ammar0xff/capstone-pdm/book_assets/audio_spec.png

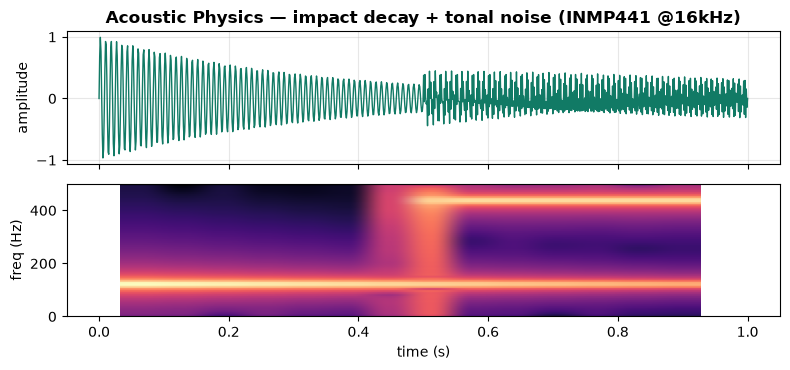
book_assets/audio_spec.png
