ammar0xff/capstone-pdm/book_assets/breadboard.png

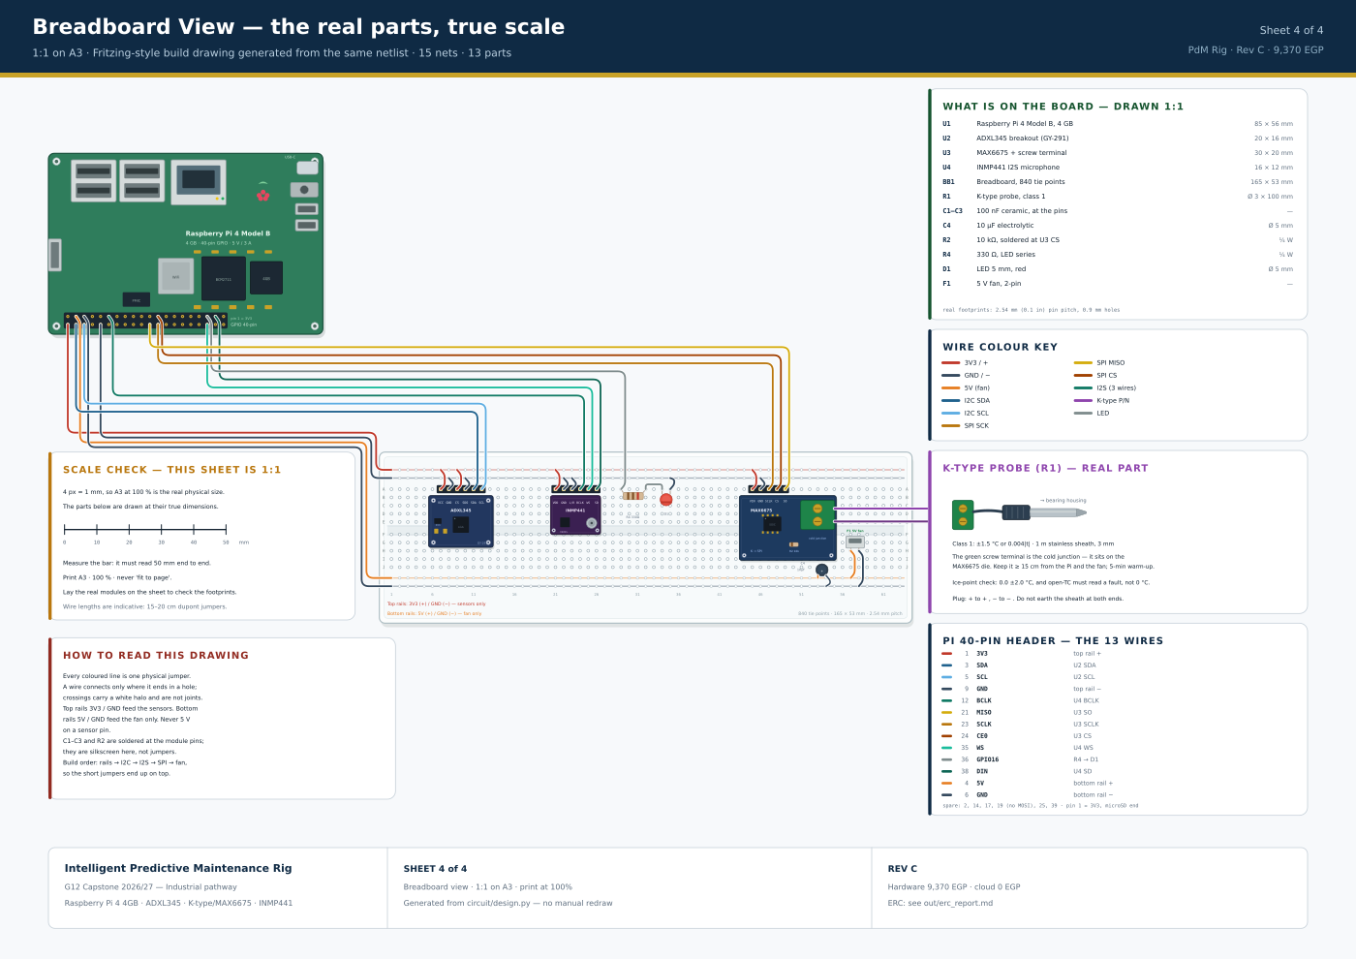
book_assets/breadboard.png
