ammar0xff/capstone-pdm/book_assets/budget.png

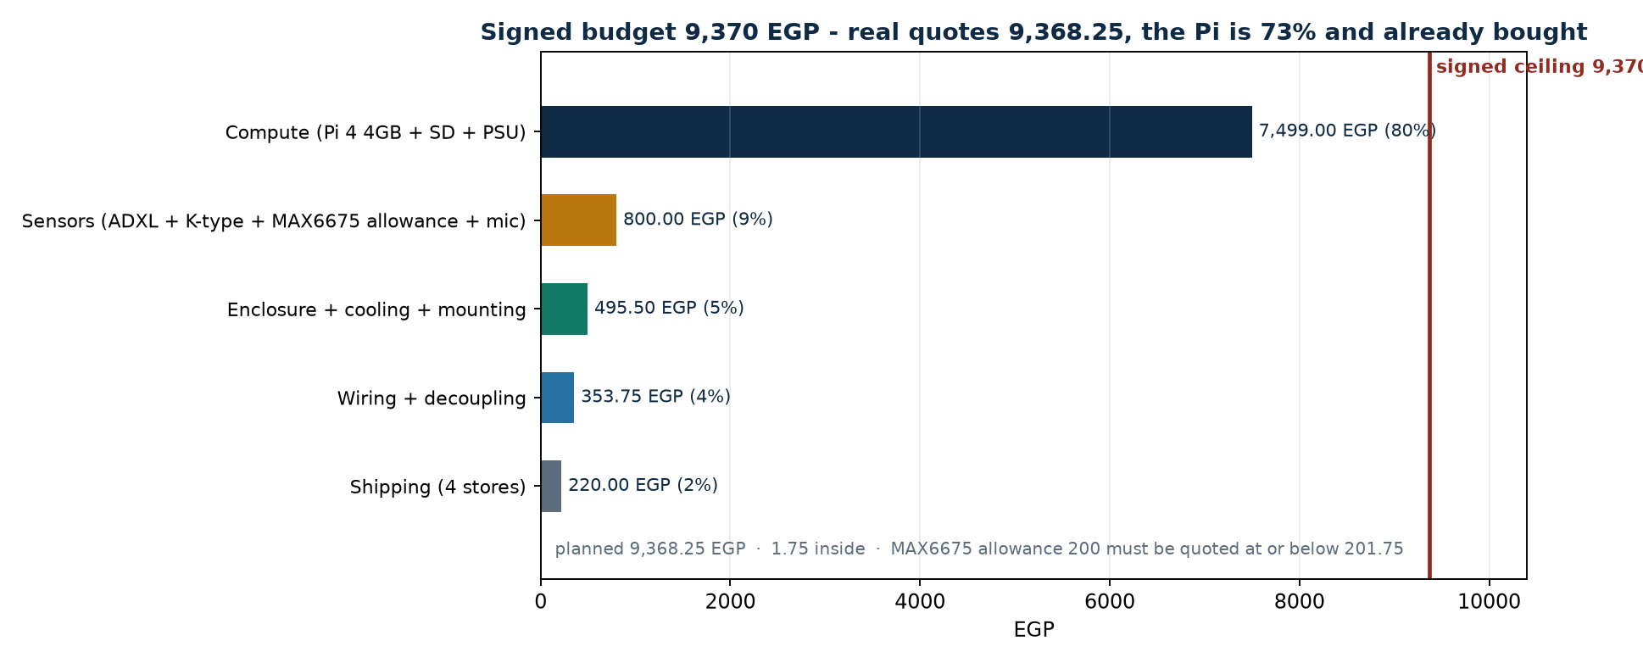
book_assets/budget.png
