ammar0xff/capstone-pdm/book_assets/confusion.png

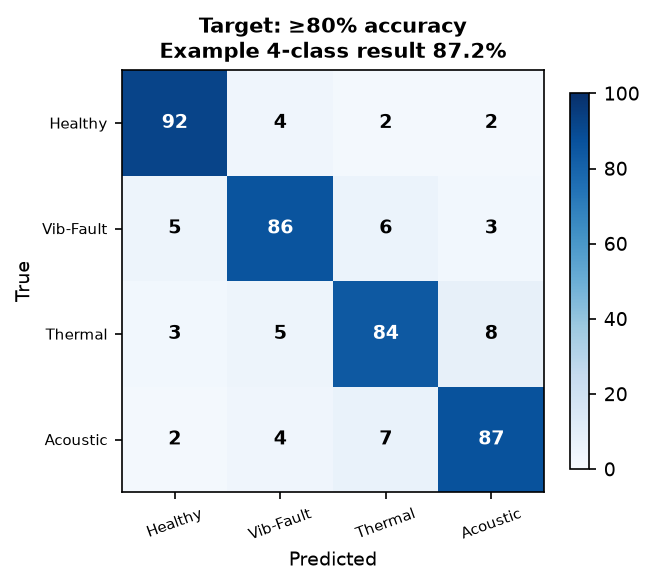
book_assets/confusion.png
