ammar0xff/capstone-pdm/book_assets/spc_chart.png

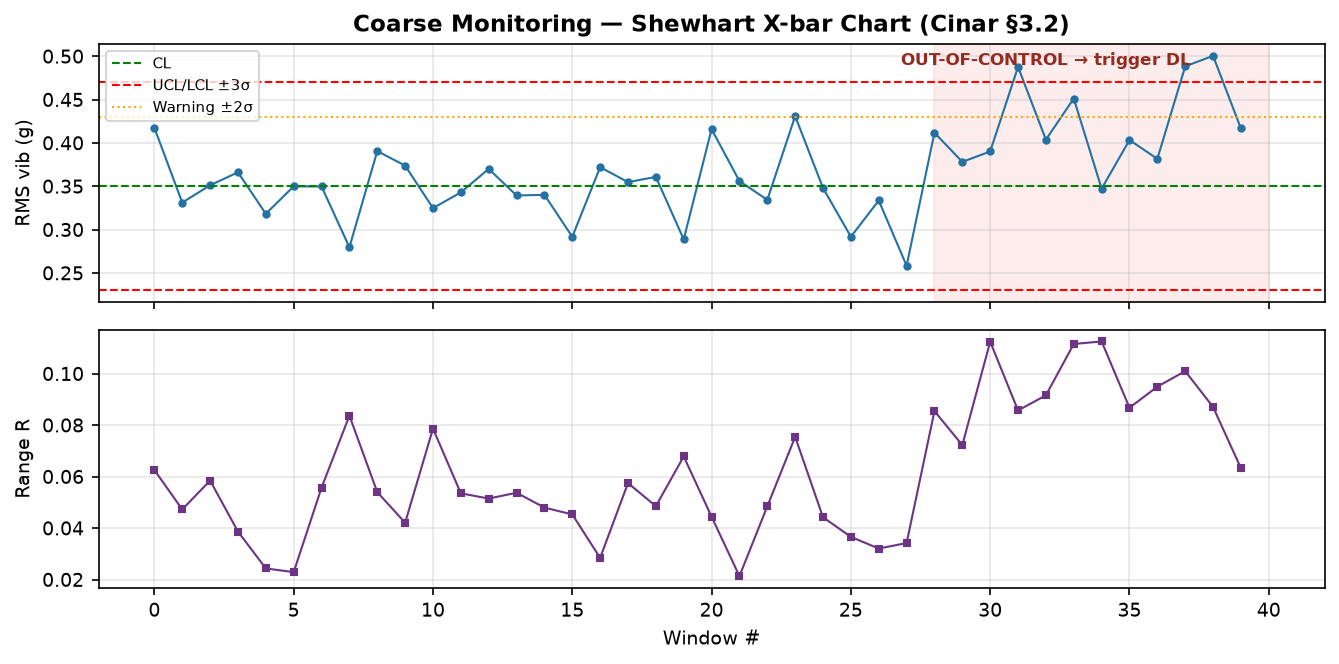
book_assets/spc_chart.png
