ammar0xff/capstone-pdm/book_assets/tc_curve.png

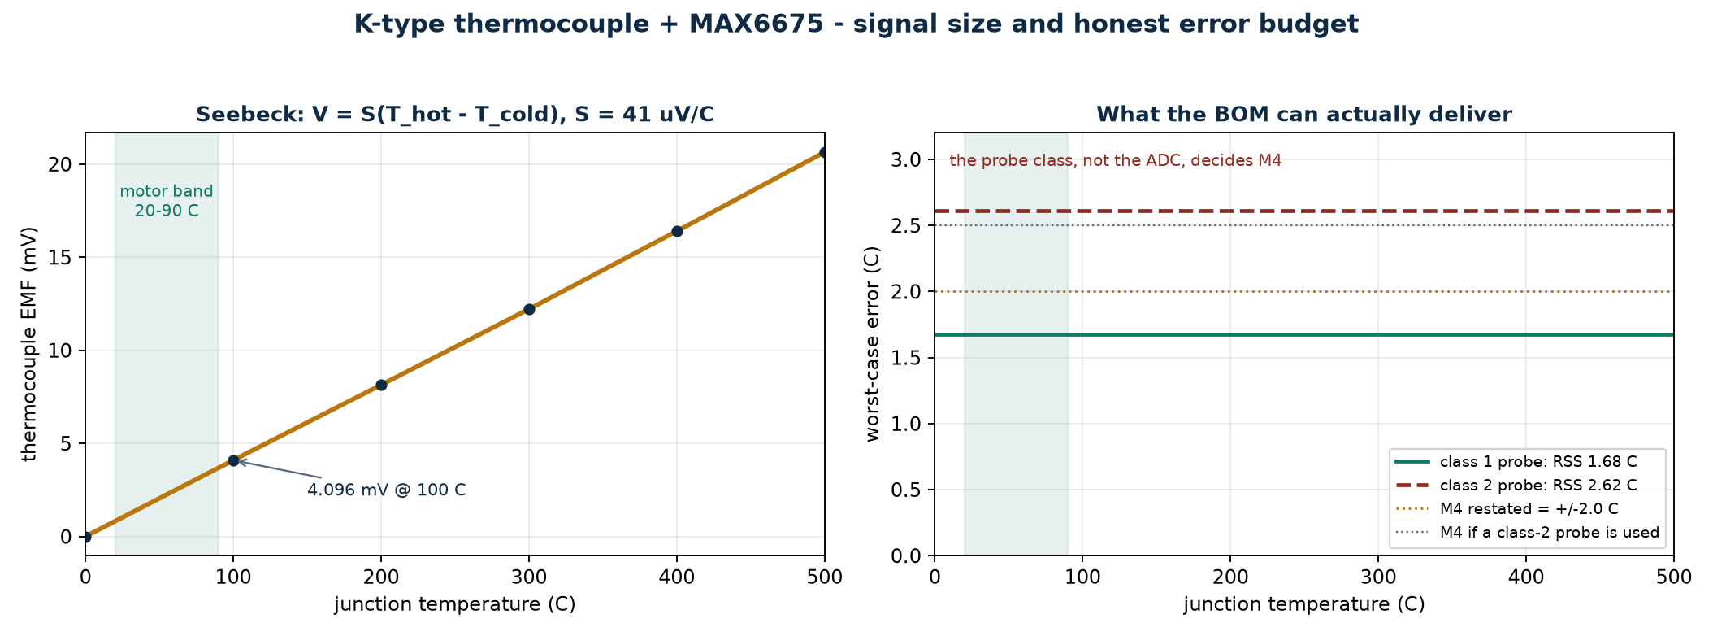
book_assets/tc_curve.png
