ammar0xff/capstone-pdm/book_assets/vibration_fft.png

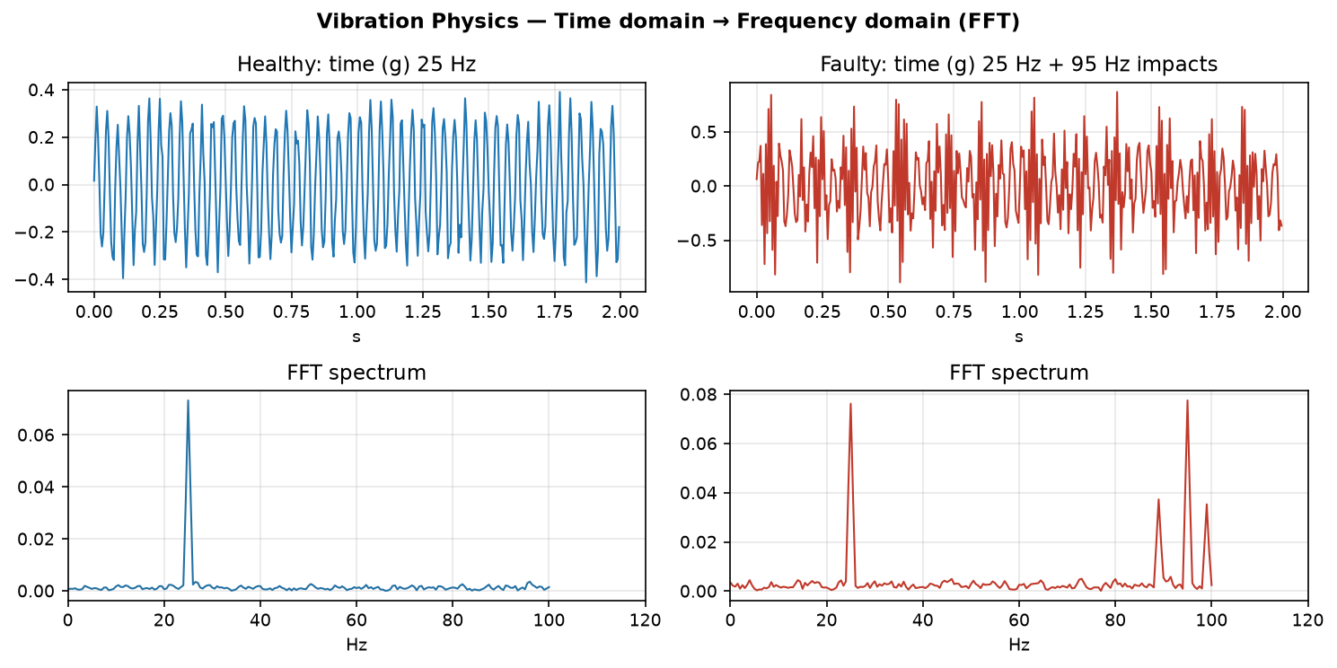
book_assets/vibration_fft.png
