ammar0xff/capstone-pdm/circuit/out/fritzing_breadboard.png

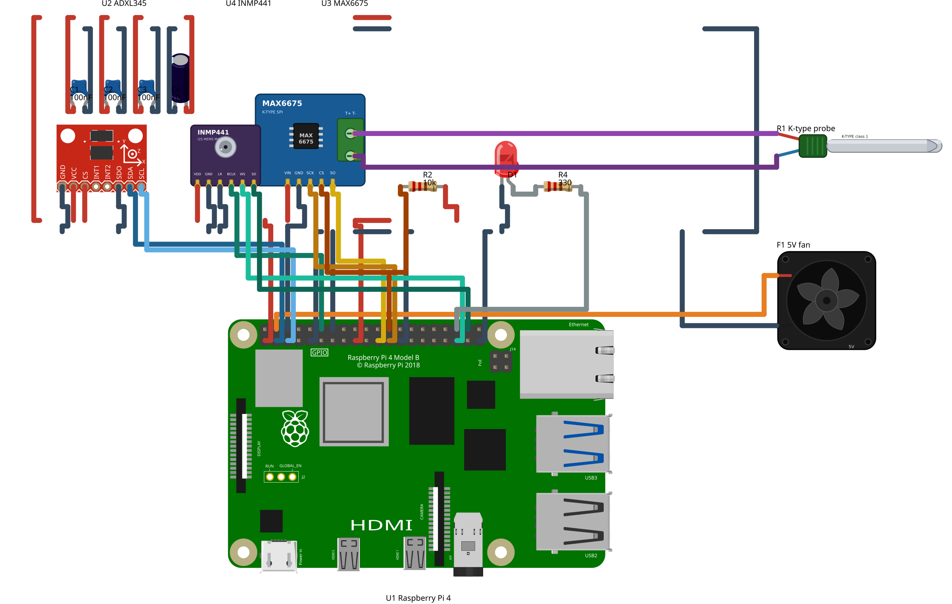
circuit/out/fritzing_breadboard.png
