ammar0xff/capstone-pdm/circuit/out/wiring_guide_perfect.html

🎉

## Unit Complete!

You nailed it, cutie 💖

✨+0 XP

Next Level ➜

Wire the Rig ✨

Edge Predictive-Maintenance Breadboard

💖❤❤❤

✨0 XP

🔥0 day streak

💡

🩺 G12 Capstone • Predictive Maintenance

# Build the Robot-Doctor Rig 🤖

Wire the Raspberry Pi, vibration sensor, heat sensor, microphone, LED and fan — step by step. Every wire ends in a numbered hole. Test each piece before adding the next.

Start Wiring ✨

robot mascot

Tap Start Wiring to begin!

Your Wiring Journey

Source of truth: circuit/design.py → circuit/fzz/routes.py → circuit/fzz/build_fzz.py.
Verified Fritzing sketch: PDM_Predictive_Maintenance.fzz (14 parts • 15 nets • 166 wires • 0 geometry problems).
Built with ❤️ for the G12 capstone — 0 EGP cloud.
