ammar0xff/capstone-pdm/circuit/out/wiring_guide.html

# 🩺 Wire the Robot-Doctor Rig

Step-by-step interactive wiring guide for your edge predictive-maintenance rig.
Follow the order — test each piece before adding the next.

Fritzing-verified • 15 nets • 14 parts • 0 geometry problems

1

## Power Rails — 3V3 & GND 🔌

⚡ Do this first. Plug the power rails before any sensor. A wrong rail can fry a module.

Raspberry Pi 4

🍓

Raspberry Pi 4 photo

Raspberry Pi 4 Model B — the brain

840 breadboard

🧱

Breadboard artwork

840-point breadboard (Fritzing art)

#### Wire by wire — top rails

From (Pi) | Net | Goes to (hole) | Wire colour | Why
Pin 1 3V3 | 3V3 | Top-left rail row W, col 1 → bridges across | #c0392b red | 3.3 V power for sensors
Pin 9 GND | GND | Top rail row X, col 3 | #34495e dark gray | Common ground
Pin 17 3V3 | 3V3 | Top rail row Y, col 29 (across gap) | #c0392b red | 3V3 to right half
Pin 14 GND | GND | Bottom rail row Z, col 27 | #34495e dark gray | GND to right half
Pin 4 5V | 5V | Direct wire to fan + (off-board, not a rail) | #e67e22 orange | Fan power only
Pin 6 GND | GND | Bottom rail row Z, col 58 → fan − | #34495e dark gray | Fan return path

#### ✅ Step 1 checklist

3V3 rail is live across the left sidered

GND rail connected to Pi pin 9 & 14dark gray

5V goes straight to fan + (no rail detour)orange

No wire crosses printed row letters or column numbersneatness

✓ Rails done — unlock Step 2

2

## ADXL345 shake-sensor 📳

✅ Prerequisite: Step 1 rails must be live and meter-checked first.

ADXL345 module

📳

ADXL345 artwork

ADXL345 3-axis accelerometer module

ADXL345 Fritzing art

🎨

Fritzing part art

ADXL345 breadboard artwork

Plug it: row J, pin 3 — pins in row J, body sits above (rows F–I).

Module pin | Net | Connects to | Wire colour | What it does
Pin 1 VCC | 3V3 | 3V3 rail (red) | #c0392b red | Module power 3.3 V
Pin 2 GND | GND | GND rail | #34495e dark gray | Common ground
Pin 3 CS | 3V3 | 3V3 rail → I2C mode | #c0392b red | Tie high = use I2C, not SPI
Pin 4 SDO | GND | GND rail → address 0x53 | #34495e dark gray | Sets I2C address to 0x53
Pin 5 SDA | I2C_SDA | Pi pin 3 | #1f618d dark blue | I2C data
Pin 6 SCL | I2C_SCL | Pi pin 5 | #5dade2 light blue | I2C clock

#### ✅ Step 2 checklist

CS → 3V3 and SDO → GND (I2C @ 0x53)critical

SDA → Pi pin 3, SCL → Pi pin 5I2C

Run i2cdetect -y 1 → must show 0x53test

✓ ADXL345 done — unlock Step 3

3

## MAX6675 heat-sensor + K-probe 🌡️

⚠️ Class-1 probe only — a class-2 probe alone is ±2.5 °C and breaks the ±2.0 °C goal.

MAX6675 module

🌡️

MAX6675 artwork

MAX6675 K-type thermocouple module

MAX6675 Fritzing art

🎨

Fritzing part art

MAX6675 breadboard artwork

Plug it: row J, pin 23. Keep the module ≥15 cm from the Pi so box heat doesn't fake a temperature rise.

Module pin | Net | Connects to | Wire colour | What it does
Pin 1 VCC | 3V3 | 3V3 rail | #c0392b red | Module supply 3.0–3.6 V
Pin 2 GND | GND | GND rail | #34495e dark gray | Common ground
Pin 3 SCK | SPI_SCLK | Pi pin 23 | #b9770e brown | SPI clock
Pin 4 CS | SPI_CS0 | Pi pin 24 + R2 to 3V3 | #a04000 dark red | Chip-select, active low
Pin 5 SO | SPI_MISO | Pi pin 21 | #d4ac0d gold | SPI data out (read-only)
Pin 6 TP / T+ | TC_P | K-probe tip + (chromel) | #8e44ad purple | Thermocouple + lead
Pin 7 TN / T− | TC_N | K-probe tip − (alumel) | #6c3483 dark purple | Thermocouple − lead

Probe: push the two K-type metal leads into the MAX6675 green screw terminal — T+ to TP, T− to TN.

#### ✅ Step 3 checklist

R2 10 kΩ pulls CS up to 3V3pull-up

Probe is CLASS 1 (±1.5 °C)critical

Ice-water test → reads 0 ±2 °C, open-TC flag = 0test

✓ Heat-sensor done — unlock Step 4

4

## INMP441 microphone 🎤

INMP441 module

🎤

INMP441 artwork

INMP441 I2S MEMS microphone module

INMP441 Fritzing art

🎨

Fritzing part art

INMP441 breadboard artwork

Plug it: row J, pin 15. Set L/R to GND for left channel.

Module pin | Net | Connects to | Wire colour | What it does
Pin 1 VDD | 3V3 | 3V3 rail | #c0392b red | Mic power 3.3 V
Pin 2 GND | GND | GND rail | #34495e dark gray | Common ground
Pin 3 L/R | GND | GND rail → left channel | #34495e dark gray | Selects left channel
Pin 4 BCLK | I2S_BCLK | Pi pin 12 | #117a65 dark teal | I2S bit clock
Pin 5 WS | I2S_WS | Pi pin 35 | #1abc9c teal | I2S word-select
Pin 6 SD | I2S_SD | Pi pin 38 | #0e6655 dark green-teal | I2S data out

#### ✅ Step 4 checklist

L/R → GND (left channel)config

BCLK → 12, WS → 35, SD → 38I2S

Run arecord -l → mic shows uptest

✓ Mic done — unlock Step 5

5

## Caps, pull-up, LED & fan 🧩

capacitor art

🔋

Capacitor artwork

100 nF ceramic caps (C1–C3)

fan art

🌀

Fan artwork

5 V cooling fan (F1)

#### Decoupling caps — row E (top rails)

C1 100 nF | row E cols 4–5 → 3V3 / GND
C2 100 nF | row E cols 7–8 → 3V3 / GND
C3 100 nF | row E cols 10–11 → 3V3 / GND
C4 10 µF | row E cols 13–14 → 3V3 / GND watch +/− polarity

#### LED chain & pull-up — row J right

R2 10 kΩ | row J cols 33–37: 3V3 → MAX6675 CS + Pi 24
R4 330 Ω | row J cols 45–49: Pi 36 → LED anode
D1 LED | row J cols 42–43: anode ← R4, cathode → GND

🌀 Fan: + to Pi pin 4 (5V, orange) direct — no rail. − to GND rail column 58 (dark gray).

#### ✅ Step 5 checklist

C1–C4 on top rails, labels clear of wiresneatness

R2 pulls MAX6675 CS idle-highpull-up

LED chain: Pi 36 → R4 → LED → GNDstatus

Fan + → Pi pin 4, fan − → GND col 58power

🎉 Rig fully wired!

🗺️

## Interactive breadboard map

Click a hole to see what's plugged there. Occupied holes show the part; wired ones show a check.

J

E

Occupied (part plugged)

Wired & verified

Empty hole

### 🏁 Final verification

15nets, all colour-coded

14parts on the board

0geometry problems (audited)

✓.fzz rebuilt & exported

Rebuild check anytime: python3 circuit/build.py → expect 44 PASS / 8 WARN / 0 FAIL.

The 8 WARNs are documented trade-offs (MAX6675 allowance needs a real quote ≤201.75 EGP, class-1 probe required, I²C cable <10 cm, sealed-box heat-spreader, SPC 2-of-3 rule).

Source of truth: circuit/design.py → circuit/fzz/routes.py → circuit/fzz/build_fzz.py (the .fzz).
Every coloured wire ends in a numbered hole — no invented connections. Built for the G12 capstone, 0 EGP cloud.
