ammar0xff/capstone-pdm/circuit/out/guide/index.html

🎉

## Level Complete!

You nailed it, cutie 💖

✨+0 XP

Next Level ➜

### Title

Body

Got it ✨

Wire the Rig ✨

Edge Predictive-Maintenance Breadboard • G12 Capstone

💖❤❤❤

✨0 XP

🔥0 day streak

🏆Achievements

🎨Nets 🩺Troubleshoot 📦Parts 🎨Comfort Rules 💰BOM

🏠

🩺 G12 Capstone • Predictive Maintenance

# Build the Robot-Doctor Rig 🤖

Wire the Raspberry Pi, vibration sensor, heat sensor, microphone, LED and fan — step by step. Every wire ends in a numbered hole. Test each piece before adding the next.

Start Wiring ✨

robot mascot

Tap Start Wiring to begin!

Your Wiring Journey

📖About This Guide

This interactive guide walks you through wiring the PdM predictive-maintenance breadboard rig. Each level matches a real section of the Fritzing sketch PDM_Predictive_Maintenance.fzz. Complete lessons, earn XP, unlock achievements, and test your circuit in the simulator.

← Back to Dashboard

Level 1

1

## Level Title

Level subtitle

0 / 0

🔌🔌 Level Title

Level description goes here.

✨ 40 XP ⏱ 10 min

### 📚 Lessons

🔧

Level artwork

Level part

Wire this part in the lessons below.

🎯Level Goal

Complete all lessons in this level to unlock the next one and earn 40 XP.

← Back to Level

📖Lesson

# Lesson Title

Lesson goal

📖 Lesson ✅ Checklist to finish

From (Pin) | Net | Connects To | Wire Colour

#### ✅ Lesson Checklist

Finish Lesson ✨

🔧

Part artwork

Part

Wire this part carefully.

← Back to Lesson

🏆

## All Levels Complete!

You've wired the entire Robot-Doctor Rig. Congratulations, engineer 💖

🏆Rig Master badge unlocked

Back to Dashboard

← Back to Dashboard

← Back to Dashboard

← Back to Dashboard

← Back to Dashboard

← Back to Dashboard

💰Budget

# Signed Ceiling: 9,370 EGP

Real quotes, real numbers. The MAX6675 is the only remaining allowance.

✅Planned Spend

9,368.25 EGP

⚠️Headroom

1.75 EGP

Item | EGP | Source

📋MAX6675 Allowance

The MAX6675 is an allowance — must be quoted ≤201.75 EGP or buy in person (−220 shipping).

Allowance: 200 EGP Max quote: 201.75 EGP Real quotes: 8,888.25 EGP

Source of truth: circuit/design.py → circuit/fzz/routes.py → circuit/fzz/build_fzz.py.
Verified Fritzing sketch: PDM_Predictive_Maintenance.fzz (14 parts • 15 nets • 166 wires • 0 geometry problems).
Built with ❤️ for the G12 capstone — 0 EGP cloud.
