ammar0xff/capstone-pdm/(list of files, drawings)

Other design files:
circuit/out/PDM_Predictive_Maintenance.fzz
