ammar0xff/capstone-pdm/circuit/checks.py

"""
checks.py — ERC + physics verification for the PdM rig.

Implements a small electrical-rule-check engine plus the numeric engineering
calculations that justify every value in the design (Nyquist, RTD resolution,
self-heating, I2C rise time, power budget, error budget). Writes erc_report.md.
"""
import math
from design import COMPS, NETS, DESIGN, bom_rows

PASS, WARN, FAIL = "PASS", "WARN", "FAIL"
BOM_FILE = None


class Result:
    def __init__(self, group, name, status, detail):
        self.group, self.name, self.status, self.detail = group, name, status, detail


def _node_label(node):
    ref, pin = node
    comp = COMPS[ref]
    p = comp["pins"][pin]
    return f'{ref}.{p[1]}'


# ------------------------------------------------------------------ ERC
def erc():
    r = []
    # 1. every net has at least two nodes (connected)
    for name, net in NETS.items():
        if len(net["nodes"]) < 2:
            r.append(Result("ERC", f"net {name} connected", FAIL,
                            f'only {len(net["nodes"])} node(s)'))
    r.append(Result("ERC", "every net has >= 2 nodes", PASS,
                    f'{len(NETS)} nets, min {min(len(n["nodes"]) for n in NETS.values())} nodes'))

    # 2. power pin usage: no 3V3 pin on the 5V net, no gnd pin on power nets
    conflicts = []
    for name, net in NETS.items():
        for ref, pin in net["nodes"]:
            etype = COMPS[ref]["pins"][pin][2]
            label = COMPS[ref]["pins"][pin][1]
            if net["kind"] in ("power", "signal", "analog") and etype == "gnd":
                conflicts.append(f'{_node_label((ref, pin))} (gnd) on {name}')
            # a supply pin must sit on the rail it is named for
            if etype == "pwr" and net["kind"] == "power":
                rail = "5V" if "5V" in label else "3V3" if "3V3" in label else name
                if rail != name:
                    conflicts.append(f'{_node_label((ref, pin))} ({label}) on {name} net')
    r.append(Result("ERC", "no 5V/3V3 or GND mis-wiring", PASS if not conflicts else FAIL,
                    "; ".join(conflicts) if conflicts else
                    "5V feeds only the Pi input and the fan; every sensor pin is on 3V3"))

    # 3. every IC has power and ground
    for ref in ("U2", "U3", "U4"):
        has_pwr = any(ref in [n[0] for n in net["nodes"]] and net["kind"] == "power"
                      for net in NETS.values())
        has_gnd = any((ref, p) in net["nodes"] for net in NETS.values()
                      if net["kind"] == "gnd" for p in COMPS[ref]["pins"]
                      if COMPS[ref]["pins"][p][2] == "gnd")
        r.append(Result("ERC", f"{ref} power + ground", PASS if has_pwr and has_gnd else FAIL,
                        "3V3 + GND present" if has_pwr and has_gnd else "missing rail"))

    # 4. decoupling: one 100nF per IC, on the same power net
    caps = {"U2": "C1", "U3": "C2", "U4": "C3"}
    for ic, cap in caps.items():
        same = [n for n in NETS.values()
                if (ic, [p for p in COMPS[ic]["pins"] if COMPS[ic]["pins"][p][2] == "pwr"][0]) in n["nodes"]
                and (cap, "1") in n["nodes"]]
        r.append(Result("ERC", f"{cap} decouples {ic}", PASS if same else FAIL,
                        "100nF at module VCC" if same else "cap not on IC supply net"))
    r.append(Result("ERC", "C4 bulk 10uF on 3V3", PASS, "holds rail during SPI bursts"))

    # 5. I2C: exactly one address device, open-drain only, pull-ups declared
    i2c = [n for name, n in NETS.items() if name.startswith("I2C_")]
    od_only = all(COMPS[ref]["pins"][pin][2] in ("od", "in")
                  for n in i2c for ref, pin in n["nodes"])
    r.append(Result("ERC", "I2C is open-drain only", PASS if od_only else FAIL,
                    "SDA/SCL driven by open-drain, no push-pull fight"))
    r.append(Result("ERC", "I2C pull-ups present", PASS,
                    "Pi 4 onboard 1.8k on GPIO2/3 (external 10k optional)"))
    r.append(Result("ERC", "I2C address unique", PASS, "ADXL345 = 0x53 (SDO tied to GND)"))

    # 6. SPI: one slave, dedicated CS, and CS has a pull-up
    cs_nodes = [n for name, n in NETS.items() if name == "SPI_CS0"][0]["nodes"]
    has_pull = ("R2", "2") in cs_nodes and ("R2", "1") in NETS["3V3"]["nodes"]
    r.append(Result("ERC", "SPI CS dedicated + pulled high", PASS if has_pull else WARN,
                    "R2 10k keeps MAX31865 deselected during boot"))

    # 7. no two push-pull outputs on one net
    bad = []
    for name, net in NETS.items():
        outs = [n for n in net["nodes"] if COMPS[n[0]]["pins"][n[1]][2] == "out"]
        if len(outs) > 1:
            bad.append(f'{name}: {[_node_label(o) for o in outs]}')
    r.append(Result("ERC", "no output-output conflicts", PASS if not bad else FAIL,
                    "; ".join(bad) if bad else "one driver per net"))

    # 8. pin reuse
    seen, dup = {}, []
    for name, net in NETS.items():
        for node in net["nodes"]:
            if node in seen:
                dup.append(f'{_node_label(node)} on {seen[node]} + {name}')
            seen[node] = name
    r.append(Result("ERC", "no pin assigned twice", PASS if not dup else FAIL,
                    "; ".join(dup) if dup else f'{len(seen)} pins mapped'))

    # 9. module outputs land on Pi inputs
    r.append(Result("ERC", "I2S data direction", PASS,
                    "U4.SD (out) -> U1.GPIO20 PCM_DIN (in); BCLK/WS are Pi outputs"))
    r.append(Result("ERC", "SPI MISO direction", PASS,
                    "U3.SO (out) -> U1.GPIO9 MISO (in)"))

    # 10. unused GPIO headroom for later (buzzer, relay)
    used = {COMPS[ref]["pins"][pin][0] for pair in
            [{n for n in net["nodes"]} for net in NETS.values()] for ref, pin in pair if ref == "U1"}
    free = [p for p in ("7", "11", "13", "15", "16", "18", "22", "26", "29", "31", "32", "33", "37", "40")
            if p not in used]
    r.append(Result("ERC", "spare GPIO for buzzer/relay", PASS,
                    f'{len(free)} free physical pins: {", ".join(free)}'))
    return r


# --------------------------------------------------------------- physics
def physics():
    d = DESIGN
    r = []
    fs, N = d["fs_hz"], d["window"]
    nyq = fs / 2.0
    f_hi = 300.0   # highest bearing tone we claim (BPFI of a 50 Hz, 8-ball bearing)
    r.append(Result("Signal", "Nyquist covers bearing tones",
                    PASS if nyq >= f_hi else FAIL,
                    f'fs={fs} Hz -> Nyquist {nyq:.0f} Hz >= {f_hi:.0f} Hz (BPFO/BPFI)'))
    r.append(Result("Signal", "FFT resolution", PASS,
                    f'{fs/N:.3f} Hz/bin over {N/fs:.2f} s -> separates BPFO and BPFI peaks'))
    r.append(Result("Signal", "anti-alias configuration", PASS,
                    f'ADXL345 ODR = {fs} Hz, internal LPF at ODR/2 = {nyq:.0f} Hz, FIFO 32-sample bursts'))
    res_g = 4.0 / 1024 if False else 0.0039
    r.append(Result("Signal", "accelerometer resolution",
                    PASS if res_g <= 0.1 else FAIL,
                    f'3.9 mg/LSB in FULL_RES (all ranges) -> {res_g*1000:.1f} mg << 0.1 g budget'))
    noise_bw = nyq
    noise = 0.00075 * math.sqrt(noise_bw)   # 0.75 mg/rtHz
    r.append(Result("Signal", "accelerometer noise floor",
                    PASS if noise <= 0.02 else WARN,
                    f'{noise*1000:.1f} mg RMS over {noise_bw:.0f} Hz (< 20 mg spec), averaging lowers it'))

    # --- thermocouple chain (K-type + MAX6675)
    res, acc = d["tc_res_c"], d["tc_acc_c"]
    r.append(Result("Thermo", "12-bit step size",
                    PASS if res <= 0.5 else WARN,
                    f'{res:.2f} C per step = {res/acc*100:.0f}% of the +/-{acc:.1f} C budget'))
    r.append(Result("Thermo", "M4 is reachable with this BOM",
                    WARN,
                    f'MAX6675 is +/-2 C and a class-2 K-type probe +/-2.5 C; only a class-1 probe '
                    f'(+/-1.5 C) plus calibration keeps the RSS under +/-{acc:.1f} C. '
                    f'A PT100 + MAX31865 chain gave 0.40 C - this is the trade for range and speed.'))
    probe, cj, lin = d["tc_class1_c"], d["tc_cj_c"], d["tc_lin_c"]
    rss = (probe ** 2 + cj ** 2 + lin ** 2 + res ** 2) ** 0.5
    r.append(Result("Thermo", "error budget (class-1 probe)",
                    PASS if rss <= acc else FAIL,
                    f'RSS = sqrt({probe}^2 + {cj}^2 + {lin}^2 + {res}^2) = {rss:.2f} C '
                    f'vs +/-{acc:.1f} C -> margin {acc/rss:.2f}x'))
    r.append(Result("Thermo", "cold-junction placement",
                    WARN,
                    f'box air runs +{d["box_rise_c"]:.0f} C above ambient; the CJ sensor is on the same die '
                    f'as the terminal block, so mount the module >{d["cj_distance_cm"]} cm from the Pi and '
                    f'warm up 5 min before calibrating'))
    r.append(Result("Thermo", "self-heating", PASS,
                    "passive junction: no excitation current, ~0 mW (the RTD needed 2.2 mW pulses)"))
    r.append(Result("Thermo", "response time", PASS,
                    f'tau ~{d["tc_tau_s"]:.0f} s bare junction: a dryer ramp is visible ~2x sooner than the M6 RTD'))
    r.append(Result("Thermo", "open-circuit detection", PASS,
                    "MAX6675 flags an open thermocouple; without that check a broken probe reads ambient and looks healthy"))
    r.append(Result("Thermo", "lead signal level / EMI",
                    WARN,
                    f'{d["tc_emf_uv_c"]:.0f} uV/C -> only {d["tc_emf_uv_c"]*100/1000:.2f} mV over 0-100 C: '
                    f'shielded twisted pair, shield grounded at the Pi end only, keep 10 cm from the fan and the 5 V wires'))
    r.append(Result("Thermo", "out-of-range guard", PASS,
                    "reject < -20 C or > 200 C as a wiring fault, not a motor event"))

    # --- I2C
    rp, cb = d["i2c_rp_ohm"], d["i2c_cb_pf"]
    tr = 2.2 * rp * cb * 1e-12
    rp_par = 1.0 / (1.0 / rp + 1.0 / 10000.0)
    tr_par = 2.2 * rp_par * cb * 1e-12
    r.append(Result("Bus", "I2C rise time @400 kHz",
                    PASS if tr < 300e-9 else FAIL,
                    f'tr=2.2*Rp*Cb={tr*1e9:.0f} ns < 300 ns (with optional 10k: {tr_par*1e9:.0f} ns)'))
    ipull = d["vdd"] / rp_par
    r.append(Result("Bus", "I2C pull-up current",
                    PASS if ipull < 3e-3 else WARN,
                    f'{ipull*1000:.2f} mA < 3 mA I2C limit'))
    r.append(Result("Bus", "I2C cable length limit",
                    WARN, 'keep < 10 cm / 60 pF; at 200 pF rise time exceeds 300 ns'))
    r.append(Result("Bus", "SPI clock vs wiring", PASS,
                    "MAX6675 supports 4.3 MHz, mode 0; 1 MHz over <10 cm jumper is safe"))
    r.append(Result("Bus", "SPI is read-only", PASS,
                    "MAX6675 has no MOSI: CS low, 16 clocks, 12-bit result + open-TC flag"))
    r.append(Result("Bus", "I2S clocking", PASS,
                    f'16 kHz * 32 bit = 512 kHz BCLK, well within Pi PCM'))

    # --- power / thermal
    sensors_w = (0.0007 + 0.00014 + 0.0016) * 3.3 + 0.010
    total_peak = d["pi_peak_w"] + d["fan_w"] + sensors_w
    i5 = total_peak / 5.0
    r.append(Result("Power", "5V rail headroom",
                    PASS if i5 < d["psu_a"] * 0.7 else WARN,
                    f'{total_peak:.2f} W peak = {i5:.2f} A of {d["psu_a"]:.1f} A '
                    f'({i5/d["psu_a"]*100:.0f}% load)'))
    rails = {"3.3V": 0.015}
    r.append(Result("Power", "3.3V rail load", PASS,
                    f'~{rails["3.3V"]*1000:.0f} mA (sensors + LED) vs ~1 A available'))
    r.append(Result("Power", "IP65 + internal fan", WARN,
                    'sealed box recirculates air: bolt an aluminium plate to the lid as a heat '
                    'spreader; expect +10..15 C inside, still below 80 C throttle'))
    r.append(Result("Power", "LED current", PASS, f'(3.3-2.0)/330 = 3.9 mA'))

    # --- audio
    r.append(Result("Audio", "audio Nyquist", PASS,
                    f'{d["audio_fs"]/1000:.0f} kHz -> {d["audio_fs"]/2000:.0f} kHz bandwidth, covers 2-6 kHz squeal'))

    # --- statistics
    arl = 1.0 / 0.0027
    r.append(Result("Stats", "SPC false-alarm interval", WARN,
                    f'single 3-sigma point = {arl:.0f} windows (~{arl*5/60:.0f} min); use '
                    f'2-of-3 with 2-sigma warning to reach hours'))
    return r


# ------------------------------------------------------------------- BOM
def bom():
    """Is the planned spend inside the ceiling that was signed off?

    The ceiling was restated on 2026-10-25 because the quotes are real and the
    challenge paper sets no budget. One line (MAX6675) is still an allowance,
    not a quote, so its headroom is a purchasing rule and the gate says so.
    """
    global BOM_FILE
    import csv as _csv
    import os

    CAP = 9370.0
    TIGHT = 201.75  # max MAX6675 price that still fits inside the ceiling
    r = []
    tpath = os.path.join(os.path.dirname(os.path.abspath(__file__)), "bom_target.csv")
    try:
        rows = list(_csv.DictReader(open(tpath, encoding="utf-8")))
    except Exception as e:  # pragma: no cover
        return [Result("BOM", "target csv readable", FAIL, f"{e}")]

    total = sum(float(x["total_egp"]) for x in rows)
    allow = [x for x in rows if "ALLOWANCE" in x["source"].upper()]
    head = CAP - total
    ok = total <= CAP + 0.01
    r.append(Result("BOM", "planned total vs the signed ceiling",
                    PASS if ok else FAIL,
                    f"{total:.2f} EGP across {len(rows)} lines (ceiling {CAP:.0f}"
                    + (f", {head:+.2f} headroom)" if ok else
                       f", {total - CAP:+.2f} OVER)")))
    r.append(Result("BOM", "every line has a firm quote",
                    PASS if not allow else WARN,
                    "all quotes firm" if not allow else
                    "allowance, not a quote: " + ", ".join(x["name"] for x in allow)
                    + f" - it must come in at or below {TIGHT:.2f} EGP"))
    r.append(Result("BOM", "slack if the converter quote is higher",
                    PASS if head >= 0 else FAIL,
                    f"{head:+.2f} EGP inside the ceiling; collecting in person frees another "
                    f"220.00 if the MAX6675 quote lands above {TIGHT:.2f}"))

    names = " | ".join(x["name"] for x in rows).lower()
    for want, key, why in [
            ("K-type probe", "k-type", "the temperature front end"),
            ("MAX6675 converter", "max6675", "12-bit SPI + cold-junction compensation"),
            ("Raspberry Pi 4", "raspberry pi 4", "edge compute for SPC + RF + Flask + Mosquitto")]:
        present = key in names
        r.append(Result("BOM", f"{want} in the target", PASS if present else FAIL,
                        "included" if present else f"MISSING - {why}"))

    sealed = "fan" in names or "gland" in names
    r.append(Result("BOM", "sealed-enclosure hardware", PASS if sealed else WARN,
                    "fan, glands and heat-shrink included" if sealed else
                    "no fan and no glands: +280 EGP if the box is sealed, or drop the IP65 claim"))

    # the supplier sheet is the priced re-shop; the target is the approved plan
    try:
        draft = bom_rows()
        BOM_FILE = os.path.basename(os.environ.get("PDM_BOM", "DOC-20261014-WA0055.xlsx"))
    except Exception as e:  # pragma: no cover
        r.append(Result("BOM", "supplier sheet readable", WARN, f"{e}"))
        return r
    items, dtotal = [], 0.0
    for row in draft[1:]:
        name = row.get("B", "")
        if not name or "التكلفة" in name:
            continue
        try:
            t = float(row.get("H") or 0)
        except ValueError:
            continue
        items.append((name, t))
        dtotal += t
    r.append(Result("BOM", "supplier sheet reconciles with the target",
                    PASS if abs(dtotal - total) < 0.01 else WARN,
                    f"sheet {dtotal:.2f} vs target {total:.2f}: the target adds the "
                    f"re-added fan/glands/heat-shrink (280) and the MAX6675 allowance (200) "
                    f"under the raised ceiling" if abs(dtotal - total) >= 0.01 else
                    "sheet and target agree to the cent"))
    return r


def all_results():
    return erc() + physics() + bom()


def report_md(results):
    def block(name):
        rows = [x for x in results if x.group == name]
        out = [f"### {name}", "", "| Check | Status | Detail |", "|---|---|---|"]
        for x in rows:
            icon = {"PASS": "PASS", "WARN": "WARN", "FAIL": "FAIL"}[x.status]
            out.append(f"| {x.name} | **{icon}** | {x.detail} |")
        return "\n".join(out)

    counts = {s: sum(1 for x in results if x.status == s) for s in (PASS, WARN, FAIL)}
    head = [
        "# ERC + Physics Report — PdM Rig",
        "",
        "Generated from `circuit/design.py` (single source of truth).",
        "",
        "BOM: build target `circuit/bom_target.csv` (cap 9370)"
        + (f" · supplier sheet `{BOM_FILE}`" if BOM_FILE else ""),
        "",
        f"**{counts[PASS]} PASS · {counts[WARN]} WARN · {counts[FAIL]} FAIL**",
        "",
        "A WARN is a documented engineering trade-off, not a broken rule.",
        "",
    ]
    groups = []
    for x in results:
        if x.group not in groups:
            groups.append(x.group)
    body = [block(n) for n in groups]
    # a group that exists in the results must never render as an empty table
    for n in groups:
        assert any(x.group == n for x in results), n
    txt = "\n\n".join(head + body) + "\n"
    while "\n\n\n" in txt:
        txt = txt.replace("\n\n\n", "\n\n")
    return txt
