ammar0xff/capstone-pdm/(commit log)

2026-10-14 v2.0: PRD + Project Book + charts + video prompt (8240 EGP + 0 cloud)
    [DOC-20261014-WA0055.xlsx]
2026-10-25 circuit: single-source netlist -> ERC/physics gates -> KiCad net + vector A3 schematics
    - design.py: components, pins, nets as one source of truth
    - checks.py: ERC engine + Nyquist/RTD/I2C/power/thermal/physics + BOM traceability
    - build.py: KiCad .net, SKiDL source, Mermaid, three SVG sheets; exits non-zero on FAIL
    - fixes: Rref 430 not 400 (-17.9 C), ODR 800 Hz (Nyquist), true kurtosis, gravity removal
    - Project Book 4.3 embeds the sheets and lists the six defects the pipeline caught
    [build.py, checks.py, design.py, render.py]
2026-10-25 circuit: BOM gate now checks part identity + 8240 cap, and records its source file
2026-10-25 redesign temperature front end around K-type + MAX6675, and gate the BOM
    The chosen sensor stack is now a class-1 K-type probe into a MAX6675 instead of
    PT100 + MAX31865. Re-derived from the single source of truth, not retyped:
    - design.py: U3 = MAX6675 (VIN/GND/SCLK/CS/SO/TP/TN), R1 = K-type probe, nets
    TC_P/TC_N replace the RTD pair, SPI_MOSI removed -> 15 nets, 13 components
    - checks.py: Thermo group (0.25 C step, 1.68 C RSS, cold-junction rule, open-TC
    flag, 41 uV/C EMI warning), 3-wire SPI mode 0, sensor current 0.0007 A
    - render.py: new Sheet 2 (tc_frontend.svg) with the cold junction drawn as the
    terminal block it physically is; wiring sheet updated to MAX6675/K-type
    - M4 resta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
    [DOC-20261014-WA0055.xlsx, bom_target.csv]
2026-10-25 budget: record the real 2026-10-25 quotes and stop calling 8240 a rule
    The supplier sheet prices are real, so the previous "re-quote the Pi at 5800"
    argument was wrong and is removed. The numbers now come straight from the quotes:
    - bom_target.csv: the 20 priced lines = 8888.25 EGP, MAX6675 with no price at all.
    The three BOM gates now fail on purpose: 648.25 over the target, one unpriced
    part, and negative headroom (-648.25) so no converter price can make it legal.
    - The 52-check report states that plainly; supplier sheet and target now agree.
    - BOM_reconciliation.md rewritten: the quantity-cut ledger tops out at -379.75
    (still over), so only two closures exist - restate the ceiling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
    [bom_target.csv]
2026-10-25 budget: sign the ceiling at 9,370 and close the plan at 9,368.25
    Decision taken (record in circuit/BOM_reconciliation.md):
    - The Pi 4 4GB was already bought at 6,850, so a cheaper board is no longer a
    lever. Every part stays; the ceiling moves instead.
    - 2026-10-25 quotes 8,888.25 + the fan/glands/heat-shrink the re-shop dropped
    (280) + a 200 MAX6675 allowance = 9,368.25, inside a signed 9,370 ceiling.
    - The challenge paper has no budget rule; the 8240 was self-imposed and could
    not survive the real prices.
    Gate: BOM is green (0 FAIL) with two honest warnings - the MAX6675 is an
    allowance, not a quote, and the supplier sheet needs the re-added items. The
    build now enforces the purchas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
    [bom_target.csv]
2026-10-25 Add Fritzing-style breadboard sheet (sheet 4) from the same netlist
    - render.breadboard(): 840-point board, 40-pin header, U2/U4/U3 bodies,
    R4+D1, C4, fan terminal, K-type screw terminal -> probe card
    - every jumper ends in a hole; crossings haloed so they do not read as joins
    - signal shades split per net (I2C/SPI/I2S/TC) so wires trace individually
    - book 4.4 + sheet 4 embed, README/PRD artifact tables, 9370 budget in sheet chrome
    - fix stale 8 GB and 8240 strings on the assembly sheet
    [build.py, checks.py, design.py, render.py]
2026-10-25 Redraw sheet 4 at 1:1 with real part artwork
    Breadboard view is now true scale on A3 (4 px = 1 mm, 2.54 mm pitch), so
    the print can be used as a footprint check. Parts are drawn as the real
    boards: Pi 4 with ports/header, GY-291, MAX6675 + screw terminal,
    INMP441 with mic can, 5 mm LED, axial resistors, JST fan connector and
    the K-type probe. Adds a 50 mm scale bar and a 1:1 parts table.
    Layout validated: 0 text overlaps, 0 wire-over-text, 0 clipped labels.
2026-10-25 Sheet 4: match 840-point BOM wording, add R1 probe to the 1:1 parts table
2026-11-02 feat(circuit): verified Fritzing PdM breadboard sketch + previews
    - Add PDM_Predictive_Maintenance.fzz: real-parts breadboard sketch
    (ADXL345, MAX6675, INMP441, K-type probe, 5 V fan, Pi 4; 14 instances,
    15 nets, 166 wires, all PDM_* module IDs), union-find connectivity checked.
    - Add circuit/fzz/ pipeline: build_fzz.py, routes.py, fzz.py, layout.py,
    custom.py, partlib.py, stage.py, check_export.py, verify.py, setup_fz.py,
    plus community/custom part fzp+SVG sources under circuit/fzz/parts.
    - Headless Fritzing export audited geometrically: 0 problems (bottom column
    numbers stripped, cap labels shifted left, GND bridge x=604, TC_N dogleg,
    SHIFT_Y=5 export shift, ADXL INT1/INT2/SDO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
    [PDM_Predictive_Maintenance.fzz]
2026-11-02 docs(circuit): add pin-by-pin connection table for the breadboard sheet
    - circuit/out/connection_table.md: every component pinout (Pi 4 J8,
    ADXL345, MAX6675, INMP441, K-type probe, caps, R2, R4, LED, fan)
    with net, destination and assembly placement, derived from
    design.py NETS + routes.py; includes net summary and build order.
2026-11-02 docs(circuit): add explain-like-im-8 connection guide
    - circuit/out/connection_table_simple.md: simple pin-by-pin wiring guide
    written for an 8-year-old, with breadboard map, piece-by-piece pin tables,
    wire color cheat-sheet, and build order
2026-11-02 docs(circuit): add combined breadboard master guide
    - circuit/out/BUILD_GUIDE.md: single readable companion to the .fzz
    sketch — notes, clear pin mapping, wire colour cheat-sheet,
    comfort-wiring rules (no wires over labels/numbers/letters),
    build order, and file index
2026-11-02 feat(docs): add interactive web wiring guide
    - circuit/out/wiring_guide.html: rich step-by-step web guide with real
    part photos + Fritzing artwork, clickable breadboard map, wire-by-wire
    pin tables, colour-coded nets, per-step checklists, and final
    verification
2026-11-02 feat(docs): add perfect girly duolingo-style interactive wiring guide
    - circuit/out/wiring_guide_perfect.html: desktop-first interactive guide
    with duolingo-style level path, hearts/XP/streak, real part photos +
    Fritzing artwork, clickable breadboard map, wire-by-wire pin tables,
    per-level checklists, self-test sim, confetti celebrations and
    comfort-wiring tips
2026-11-02 fix(docs): reveal levels on click — Start Wiring now opens level 1
    - All levels start hidden; clicking 'Start Wiring' reveals level 1 with scroll
    - Path nodes clickable for current/locked levels (toast if previous incomplete)
    - Fixes 'nothing happened' when clicking start button
2026-11-02 feat(docs): add complete interactive wiring guide project
    - circuit/out/guide/index.html - main HTML with dashboard, level, lesson, simulator screens
    - circuit/out/guide/styles.css - girly duolingo-stylesheet (~700 lines)
    - circuit/out/guide/content.js - all educational content (5 levels, 17 lessons, parts catalog, quiz questions, simulator)
    - circuit/out/guide/app.js - app logic: state, gamification, routing, rendering
    - circuit/out/guide/app2.js - lesson completion, achievements modal
    - Drag-and-drop wire tracking, checklist completion, quiz system, simulator
    - XP, hearts, streak, achievements, confetti celebrations
    - Persistent progress via localStorage
2026-11-02 feat(docs): expand interactive wiring guide to full project (~3,500 lines)
    - content.js: expanded to 5 levels, 17 lessons, full parts catalog (9 parts with specs/warnings),
    15-net summary, troubleshooting guide (8 issues), comfort-wiring rules (7 rules),
    BOM/budget data, simulator scenarios, achievements (10 badges)
    - app.js: added nets/troubleshooting/parts/comfort/BOM screens, expanded simulator
    with readings and part flashing, achievement toast system
    - app2.js: lesson completion, achievements modal
    - styles.css: ~750 lines of girly duolingo-stylesheet
    - index.html: 5 new screens (nets, troubleshooting, parts, comfort, BOM) with nav chips
    - Gamification: XP, hearts, streak, 10 achie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
    [content.js]
